monishram2508/strain-measurement-project/simulation/Strain_measurement.asc

C1: Cap; 1m
C2: Cap; 660n
R1: res; 120
R2: res; 120
R3: res; 120
R4: res; {120*(1+strain)}
R5: Res; 10k
R6: Res; 10k
R7: Res; 40
R8: Res; 10k
R9: Res; 10k
R10: Res; 10k
R11: Res; 10k
R12: Res; 47k
R13: Res; 47k
R14: Res; 87.5k
R15: Res; 12.5k
R16: Res; 47k
R17: Res; 24k
R18: Res; 10k
R19: Res; 10k
R20: Res; 10k
U1: UniversalOpAmp2
U2: UniversalOpAmp2
U3: UniversalOpAmp2
U4: UniversalOpAmp2
U5: UniversalOpAmp2
U6: UniversalOpAmp2
U7: UniversalOpAmp2
V1: voltage; 5
V2: voltage; 15
V3: voltage; -15
Named nets: 0, V+, V-, VA, VB, 5V
.include "ad620.cir"
.param strain=0
.step param strain -0.001 0.001 0.0001
.op
.dc param strain 0 0.001 0.00001
