monishram2508/strain-measurement-project/docs/strain-measurement-report.pdf

# IoT-Enabled Cantilever Beam Load Measurement System Using Strain Gauges

## Electronics Workshop II - Project Report

### Monishram Selvaraj Roll No: 2024102076

monishram.selvaraj@students.iiit.ac.in

### Neel Rajesh Roll No: 2024102007

neel.rajesh@students.iiit.ac.in

### International Institute of Information Technology Hyderabad

## 1 Introduction

Load and weight measurement is a fundamental requirement across a wide range of engineering applications, including structural health monitoring, industrial automation, weighing systems, and biomechanical research. Resistive strain gauges remain one of the most widely used transducers for such measurements due to their high sensitivity, small form factor, and well-understood electromechanical behaviour.
The fundamental operating principle of a resistive strain gauge is based on the piezoresistive effect: when a conductive element is mechanically deformed, its electrical resistance changes in proportion to the applied strain. For a metallic foil gauge, this relationship is characterised by the Gauge Factor (GF), defined as:

GF =

∆R/R
ε

(1)

where ∆R is the change in resistance, R is the nominal resistance, and ε is the mechanical strain. For standard metallic foil gauges, GF ≈ 2.
Despite widespread use, practical strain gauge systems present significant engineering challenges. The output signal of a Wheatstone bridge driven by a 5 V excitation and loaded with a typical foil gauge is in the millivolt range, necessitating high-gain, low-noise amplification before digitisation. Furthermore, thermal effects, common-mode interference, and bridge imbalance from manufacturing tolerances must be carefully managed.
This work addresses these challenges through a complete bottom-up system design, encompassing: (1) a half-bridge Wheatstone configuration for temperature-compensated differential sensing; (2) a custom discrete instrumentation amplifier for high-gain differential amplification; (3) an active signal conditioning stage for offset correction and low-pass filtering; and (4) an IoT subsystem for wireless data acquisition and live dashboard visualisation. The remainder of this paper is structured as follows. Section 3 covers the Wheatstone bridge design and analysis. Section 4 describes the instrumentation amplifier. Section 5 presents the signal conditioning stage. Section 6 details the IoT implementation. Section 8 presents experimental results, and Section ?? concludes the paper.

## 2 System Overview

The complete system signal chain is illustrated in Fig. 1. The strain gauges are bonded to the top and bottom surfaces of an aluminium cantilever beam. When a load is applied at the free end, one gauge experiences tensile strain and the other compressive strain, producing a differential resistance change. This differential signal is extracted by the Wheatstone bridge, amplified by the instrumentation amplifier, conditioned by the summing and filtering stage, digitised by the HX711, and transmitted wirelessly by the ESP32 to a local MQTT broker and Node-RED dashboard.

Wheatstone
Bridge

Instrumentation
Amplifier

Summer +
LPF

HX711

ADC | ESP32 | IoT Dashboard

Figure 1: System block diagram showing the complete signal chain from mechanical strain to IoT dashboard.

## 3 Wheatstone Bridge

### 3.1 Configuration and Motivation

The Wheatstone bridge is the fundamental transduction interface that converts the resistance change of the strain gauge into a measurable differential voltage. A half-bridge configuration was selected, comprising two active strain gauges (SG1, SG2) and two fixed resistors (R1, R2), as shown in Fig. 2.

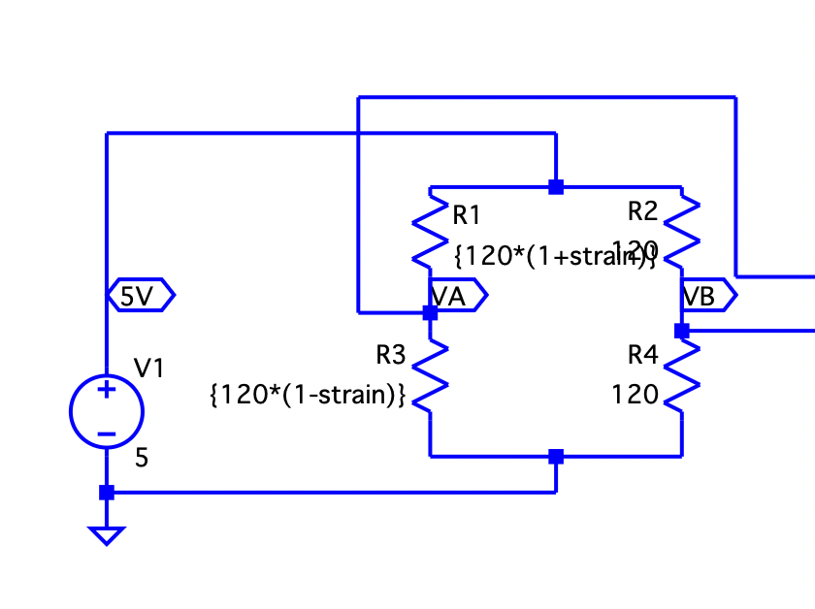
[picture p1: figure]

Figure 2: Half-bridge Wheatstone bridge schematic from LTspice. SG1 is bonded to the tensile face and SG2 to the compressive face of the cantilever beam. Fixed resistors R1 = R2 = 100 Ω.

The half-bridge configuration was preferred over a quarter-bridge for two key reasons:

1. Doubled sensitivity: With one gauge in tension and the other in compression, both contribute additively to the differential output, doubling the effective bridge output compared to a quarter-bridge arrangement.
2. Passive temperature compensation: Since both gauges are bonded to the same beam and experience the same ambient temperature, thermally induced resistance changes are common-mode and cancel differentially, significantly reducing thermal drift in the output signal.

### 3.2 Bridge Analysis and Output Voltage

The nominal resistance of the strain gauges was measured at 121.8 Ω. Under applied load, the gauges exhibit a resistance change of approximately ±0.5 Ω, corresponding to a strain of:

ε =

∆R/R
GF =

0.5/121.8
2
≈ 2050 µε | (2)

The differential output voltage of the half-bridge, with excitation voltage Vex = 5 V (from the ESP32 VIN pin), is given by:

Vdif f =

∆R
4R
- Vex | (3)

For ∆R = 0.5 Ω, R = 120 Ω, Vex = 5 V:

Vdif f =

0.5
4 × 120
× 5 ≈ 5.2 mV | (4)

This millivolt-level output confirms the necessity of high-gain amplification in the subsequent stage.

### 3.3 LTspice Simulation

The bridge was simulated in LTspice using a parametric resistance sweep to emulate strain variation:

. param strain =0
. step param strain -0.001 0.001 0.00005
R4 = {120*(1+ strain ) }

The simulation confirmed a linear differential output ranging from −2.5 mV to +2.5 mV across the swept strain range, consistent with theoretical predictions.

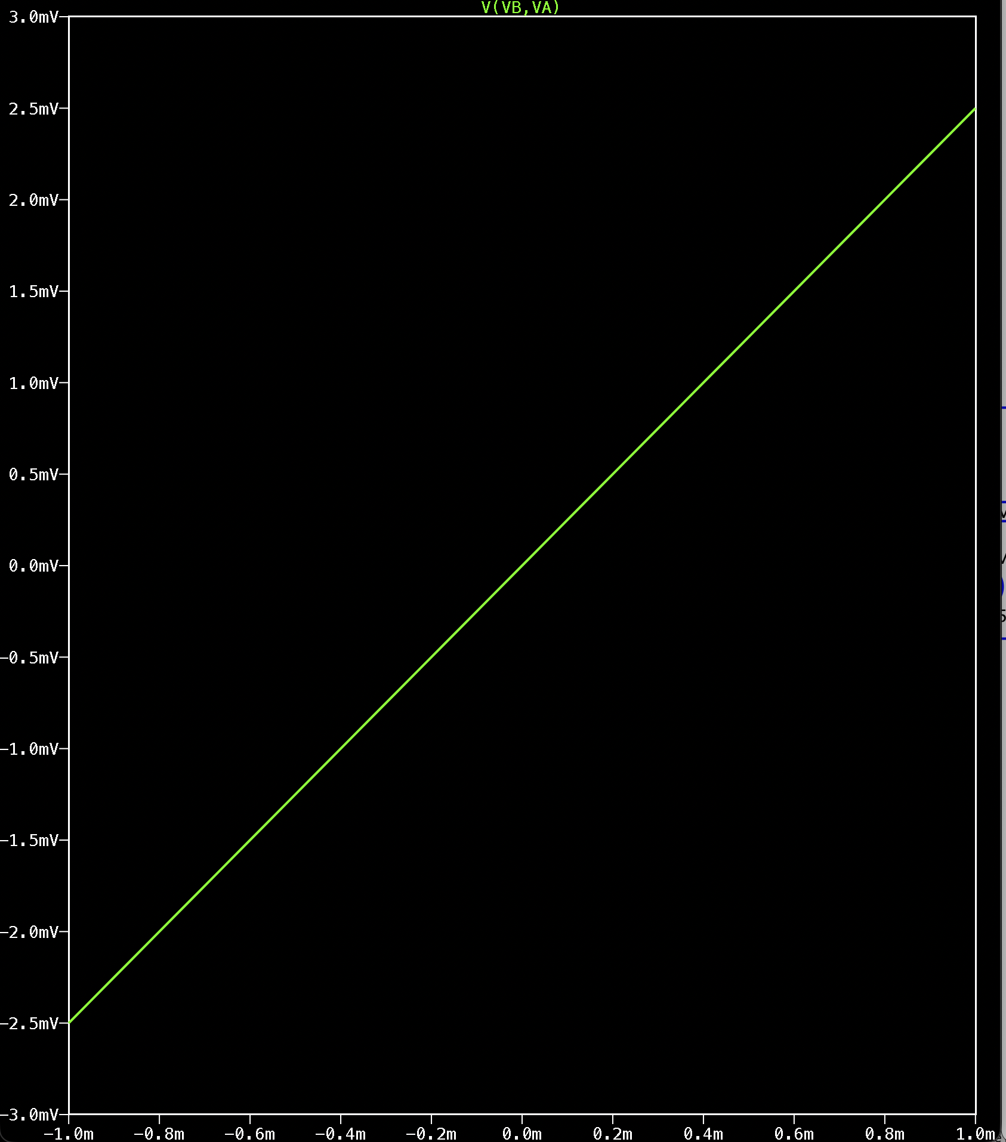
[picture p2: figure]

Figure 3: LTspice DC sweep result showing the differential bridge output V (A) − V (B) as a function of the strain parameter. The linear response from −2.5 mV to +2.5 mV confirms correct bridge operation.

### 3.4 Bridge Balancing Challenges

In practice, the fixed resistors measured 98 Ω and 99 Ω respectively (rather than an ideal 100 Ω), and the two strain gauges had slightly different nominal resistances. This resulted in a non-zero differential output at rest, observed as approximately −12 mV steady-state offset. This was addressed in software using the HX711 tare function, which captures and subtracts the resting output from all subsequent readings. To stick the strain gauge resistors onto the metal sheet was a tedious process. We had to sandpaper the metal sheet and make it as smooth as possible to ensure there were no bubbles after sticking it.

## 4 Custom Instrumentation Amplifier

### 4.1 Motivation and Design Choice

An instrumentation amplifier (INA) is required to amplify the small differential bridge output while rejecting common-mode interference. A discrete three-op-amp INA topology was implemented in hardware due to its high common-mode rejection ratio (CMRR), differential gain control via a single resistor, and high input impedance which minimises bridge loading. The AD620 was used as the reference model during LTspice simulation, with the hardware implementation realised using discrete op-amps in the classical three-op-amp INA configuration.

### 4.2 Circuit Topology

The three-op-amp INA consists of two input buffer amplifiers (U1, U2) followed by a differential output stage (U3), as shown in Fig. 10.

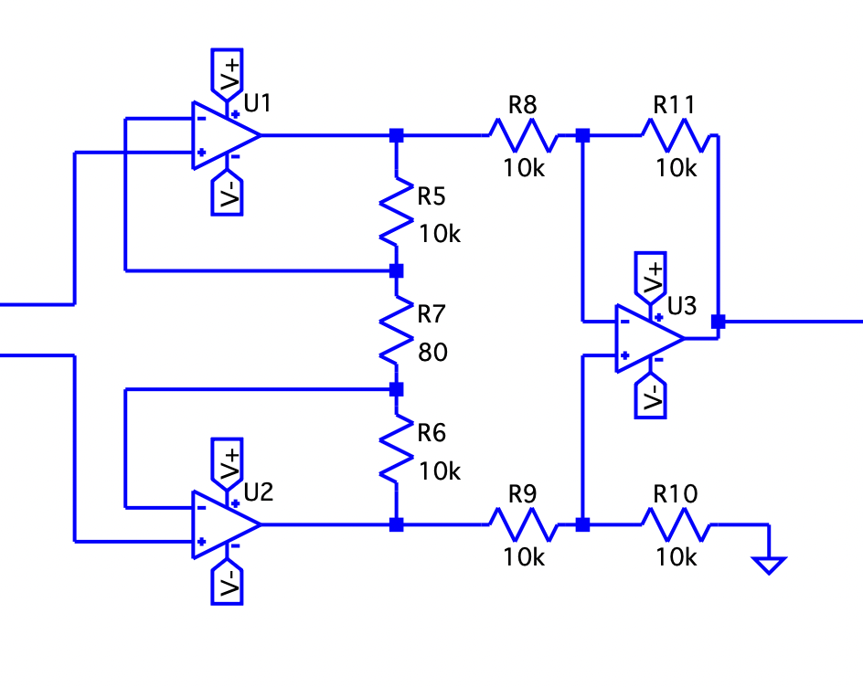
[picture p3: figure]

Figure 4: Custom three-op-amp instrumentation amplifier implemented in LTspice. U1 and U2 act as input buffers, while U3 forms the differential output stage. Gain is controlled by RG.

### 4.3 Gain Calculation

The gain of the three-op-amp INA is given by:

G = 1 +

2Rf
RG

(5)

where Rf is the feedback resistor and RG is the gain-setting resistor. In the hardware implementation, RG was realised as a 40 Ω fixed resistor in series with a 5 kΩ potentiometer, enabling continuously variable gain.
The required gain was derived from the desired output voltage range. To swing the output over a useful range of ≈ 3 V from a 4.7 mV bridge signal:

Grequired =

Vout

Vdif f

=

3
0.0047
≈ 638 | (6)

In practice, the gain was tuned empirically via the potentiometer (it increases or decreases the value of RG) to avoid saturation while maximising dynamic range.

### 4.4 Common-Mode Rejection

The INA topology inherently rejects common-mode signals. With matched resistors, the CMRR is theoretically infinite; in practice, resistor mismatch limits CMRR to typically 80 dB for discrete implementations. This is sufficient to reject 50 Hz mains interference and switching noise from the ESP32’s WiFi radio, both of which appear as common-mode signals on the bridge output lines.

### 4.5 Simulation Results

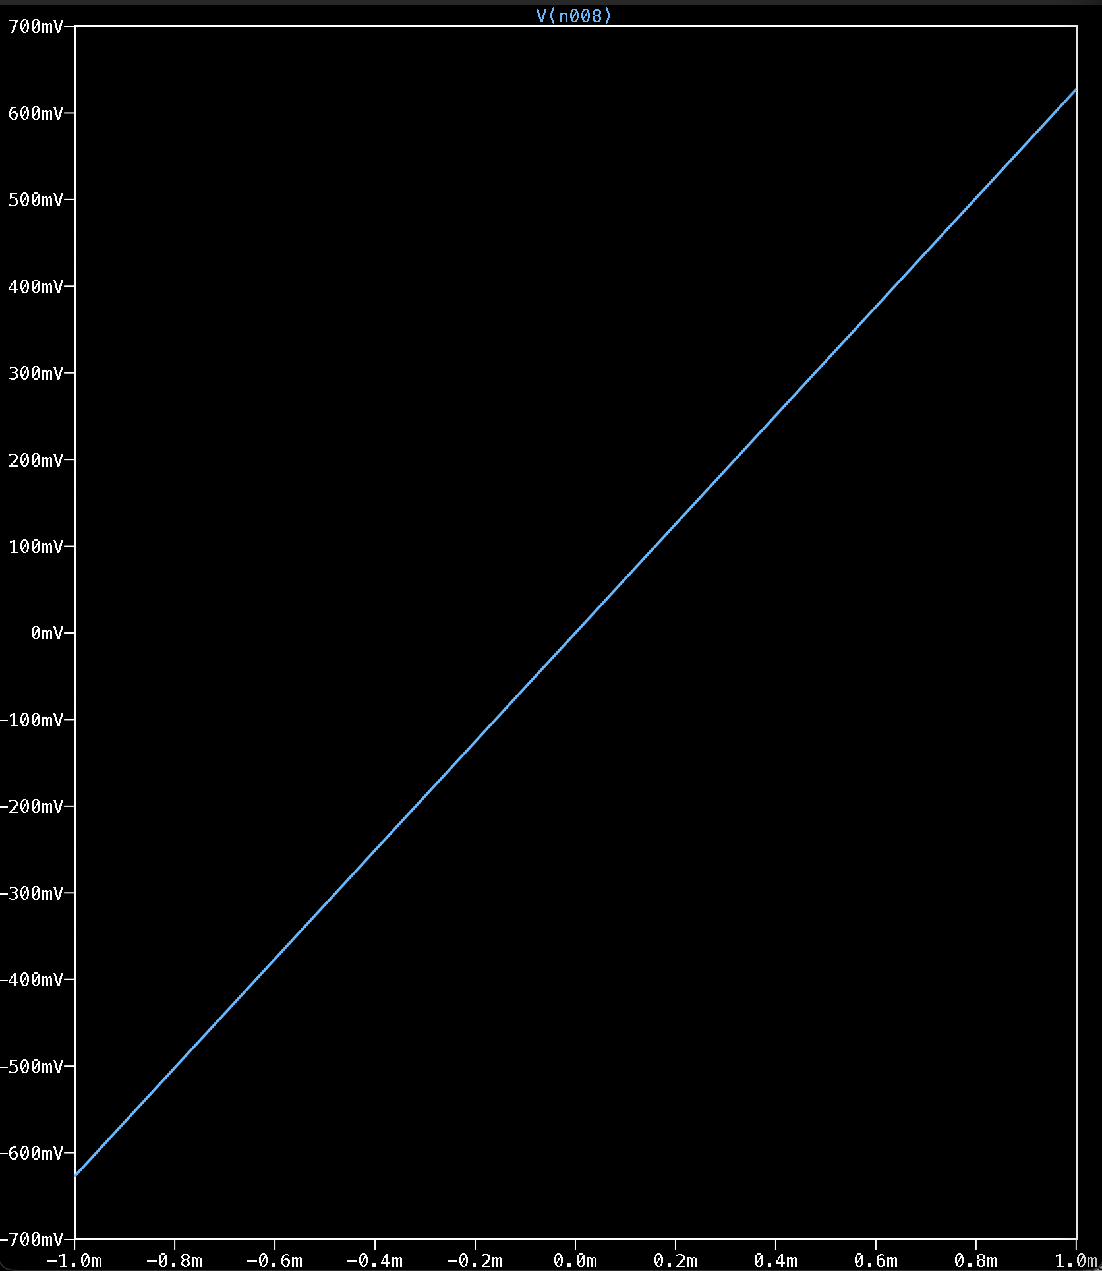
[picture p4: figure]

Figure 5: LTspice simulation of the instrumentation amplifier output versus strain sweep. The amplified output exhibits a linear response consistent with the designed gain and is centered around 0V.

## 5 Signal Conditioning: Inverting Summer and Low-Pass Filter

### 5.1 Overview

Following amplification, the signal requires two further processing steps before digitisation:

1. DC offset correction: The INA output carries a DC offset due to bridge imbalance and the REF pin voltage. An inverting summing amplifier is used to subtract this offset, centering the signal around zero.
2. Low-pass filtering: High-frequency noise from power supply ripple, mechanical vibration, and electromagnetic interference must be attenuated. An active low-pass filter with gain achieves this.

### 5.2 Inverting Summing Amplifier

The inverting summing amplifier combines the INA output with a precision DC reference voltage (Vref = 0.6 V), generated by a unity-gain voltage buffer (U6) driven by a resistor divider from the 5 V supply:

Vref = Vsupply ×

R15

R14 + R15

= 5 ×

12.5 k
87.5 k + 12.5 k = 0.625 V | (7)

The summing amplifier output is:

Vsum = −

Rf

Rin1

VINA +

Rf

Rin2

Vref
(8)

With Rin1 = Rin2 = Rf = 47 kΩ, this gives unity summing gain with sign inversion, effectively subtracting the reference from the INA output.

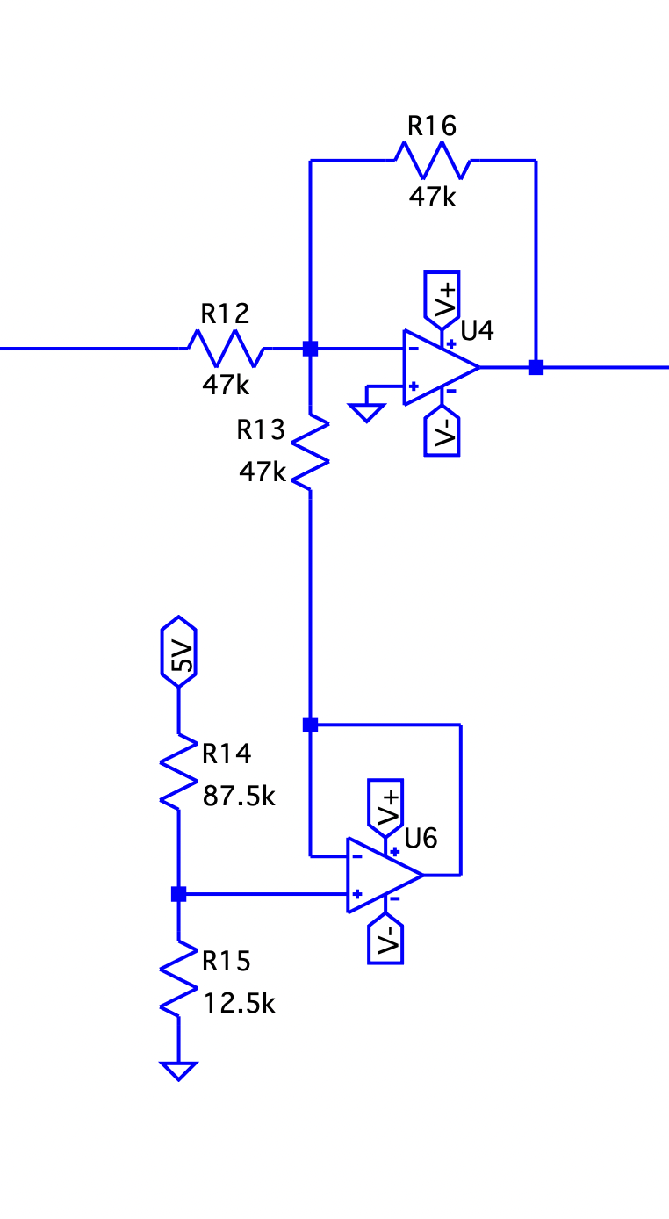
[picture p5: figure]

Figure 6: LTspice schematic of the inverting summing amplifier and voltage reference buffer. R12, R13, R16 = 47 kΩ; R14 = 87.5 kΩ; R15 = 12.5 kΩ.

### 5.3 Active Low-Pass Filter with Gain

An active Sallen-Key low-pass filter with additional gain was implemented following the summing stage. The cutoff frequency is given by:

fc =

1
2πRC | (9)

For R = 10 kΩ and C = 1 µF:

fc =

1
2π × 10 k × 1 µ
≈ 15.9 Hz | (10)

This cutoff frequency is appropriate for quasi-static load measurement: structural loads change slowly (well below 10 Hz), while the dominant noise sources (50 Hz mains, WiFi switching at MHz frequencies) are well above the passband. The filter attenuates these at −20 dB/decade.
An additional gain stage (R17 = 24 kΩ, R18 = 10 kΩ, C2 = 660 nF) follows the filter to scale the output to a 0–3 V range suitable for the subsequent ADC stage.

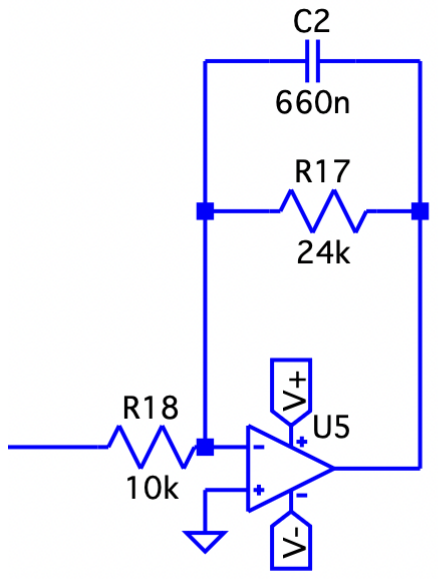
[picture p6: figure]

Figure 7: LTspice schematic of the active low-pass filter with gain stage. R17 = 24 kΩ, R18 = 10 kΩ, C2 = 660 nF.

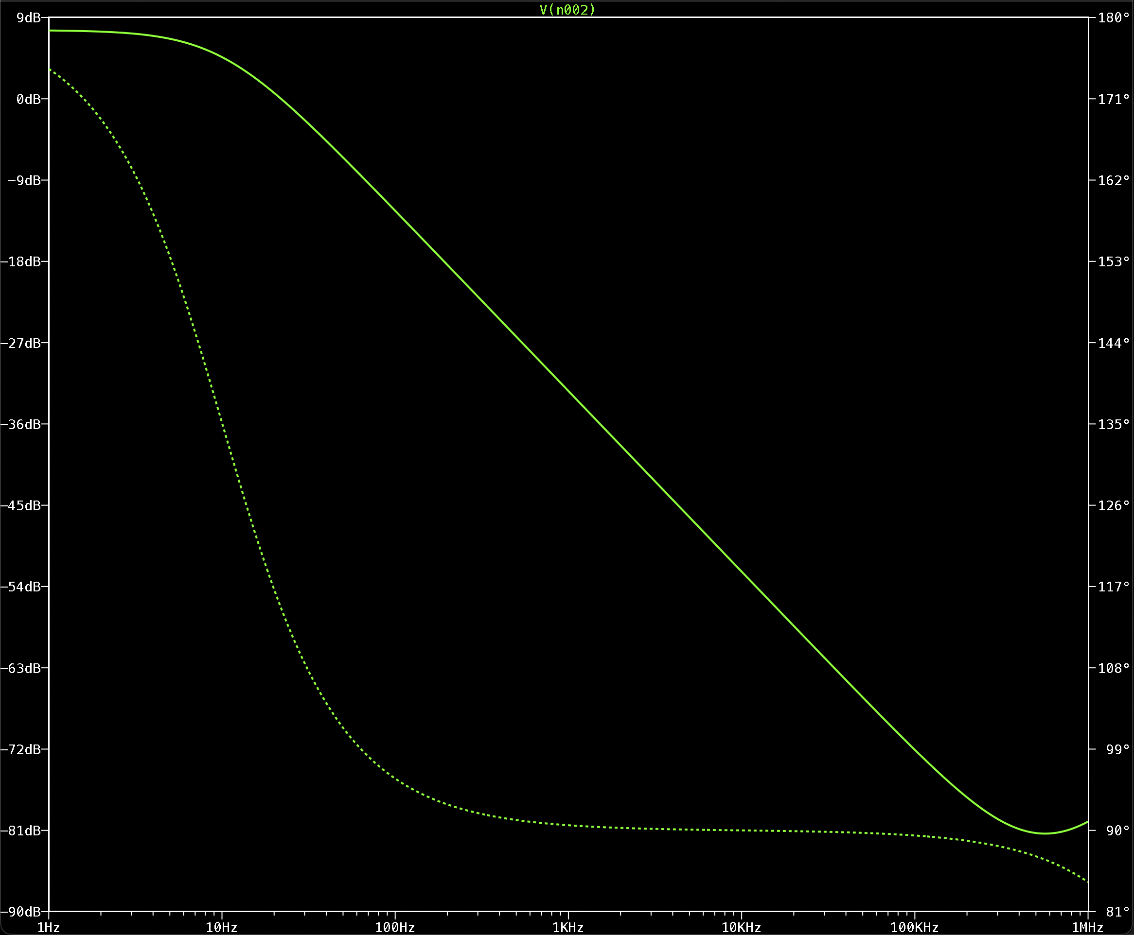
[picture p7: figure]

Figure 8: AC analysis of the low-pass filter stage, showing the −3 dB cutoff at approximately 15.9 Hz and −20 dB/decade roll-off beyond the passband.

### 5.4 Output Range Verification

The complete analog signal chain produces an output in the range of 0 V to 3 V, verified in both simulation and hardware. At zero strain, the output is centred near 1.5 V; at maximum compressive strain the output approaches 0 V, and at maximum tensile strain it approaches 3 V.

## 6 IoT Implementation

### 6.1 System Architecture

The IoT subsystem was designed to transmit weight measurements wirelessly to a live browser dashboard with minimal latency. The architecture is entirely local — no cloud services are used — ensuring low latency, privacy, and operation without internet connectivity. The stack comprises:

- HX711: 24-bit sigma-delta ADC with integrated programmable gain amplifier, designed specifically for Wheatstone bridge interfacing.
- ESP32: Dual-core 240 MHz microcontroller with integrated WiFi, running the Arduino framework.
- Mosquitto: Open-source MQTT broker running locally on a laptop.
- Node-RED: Flow-based visual programming environment hosting the dashboard at http://localhost:1880/ui.

### 6.2 HX711 ADC Interface

The HX711 was selected over the ESP32’s internal 12-bit SAR ADC for two reasons: its 24-bit resolution provides significantly finer quantisation (16 million counts versus 4096), and its dedicated differential input is optimised for Wheatstone bridge signals, with an internal PGA supporting gains of 32, 64, and 128.
In this implementation, the bridge output was connected directly to the HX711 Channel A inputs (A+, A-) at a gain of 128, bypassing the external instrumentation amplifier for the final hardware configuration. The HX711 effective input range at gain 128 and Vsupply = 4.5 V is:

Vin,max = ±

Vsupply
2 × Gain = ±

4.5
2 × 128
≈ ±17.6 mV | (11)

The HX711 communicates with the ESP32 via a custom two-wire serial protocol using a clock pin (SCK, GPIO5) and data pin (DT, GPIO4).

### 6.3 MQTT Communication

Weight data is published to the MQTT topic strain/weight at 2 Hz. The ESP32 acts as an MQTT client connecting to the Mosquitto broker at the laptop’s local IP address over the shared WiFi hotspot. Node-RED subscribes to this topic and updates the dashboard gauge widget in real time.
The MQTT protocol was selected for its low overhead, publish-subscribe architecture, and native support in both the ESP32 Arduino ecosystem (PubSubClient library) and Node-RED.

### 6.4 Calibration Procedure

Empirical calibration was performed by placing objects of known weight on the beam and recording the corresponding raw HX711 counts after taring. The scale factor k (counts per gram) is defined as:

k =

Craw
m

(12)

where Craw is the tared raw count and m is the known mass in grams. The calibration data is presented in Table 1.

Table 1: Empirical Calibration Data

Object | Mass (g) Raw Count Scale Factor (counts/g)
iPhone 16 Pro | 210 | 7000 | 33.3
JBL Go 2 | 184 | 6750 | 36.7
AirPods Pro 3 | 55 | 5509 | 100.2
Water Bottle (300 ml) | 310 | 7961 | 25.7
Average | – | – | 49.0

The variance in scale factor across the calibration objects reflects several practical factors: the nonlinearity of the beam’s mechanical response at different load levels, the sensitivity of the half-bridge to load placement position on the beam, and the thermal drift of the gauge resistance between measurements. A more robust calibration would involve a polynomial fit across a wider and denser set of reference masses, which is identified as future work.

### 6.5 Firmware

The ESP32 firmware was developed in the Arduino framework. The core measurement loop reads averaged HX711 counts, applies the scale factor, publishes the result to MQTT, and prints to the serial monitor simultaneously. A software tare routine captures the resting baseline count on demand and subtracts it from all subsequent readings, compensating for bridge imbalance and thermal offset.

Listing 1: Core ESP32 firmware loop

void loop () {
if (! client . connected () ) reconnect () ; client . loop () ;

if ( scale . is_ready () ) {
long raw = scale . read_average (20) ;
long adjusted = raw - zero_offset ;
float weight = adjusted / calibration_factor ; char msg [50];
dtostrf ( weight , 6 , 2 , msg ) ;

client . publish (" strain / weight ", msg ) ; Serial . print (" Weight :␣") ;
Serial . print ( weight ) ;
Serial . println ("␣g") ;
}
delay (500) ;
}

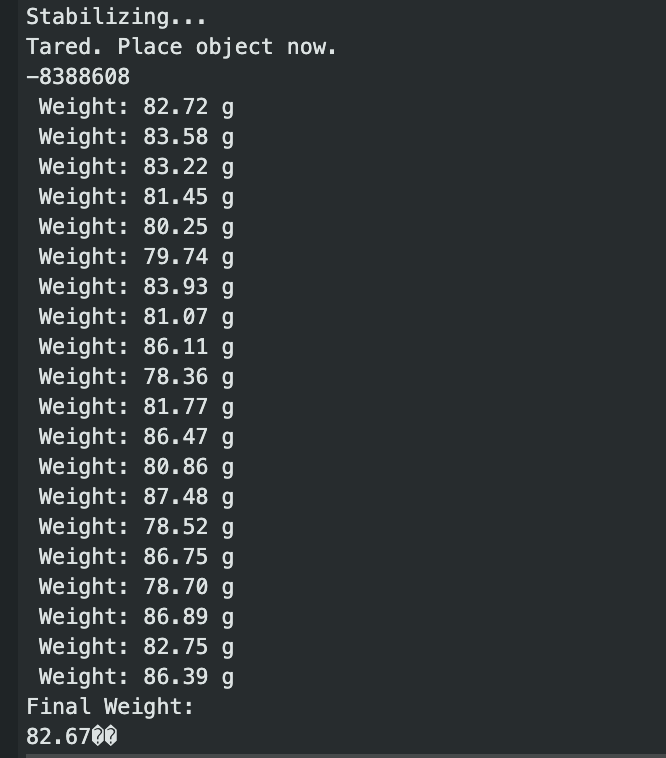
[picture p8: figure]

Figure 9: Real-time weight of the adapter measured by the strain gauge on serial monitor

## 7 Challenges and Solutions

The development process surfaced several non-trivial engineering challenges, each of which required systematic diagnosis and resolution.

### 7.1 Thermal Drift

Observation: On power-up, HX711 raw counts drifted from approximately +50,000 to near zero over a 15–20 minute period, even without any applied load.
Root Cause: Self-heating of the strain gauges due to excitation current. The excitation current through a 120 Ω gauge at 4.5 V generates ohmic heating, raising the gauge temperature and consequently its resistance. This is a well-known phenomenon in strain gauge metrology called self-heating error.
Solution: A mandatory warm-up period of 15–20 minutes was incorporated into the measurement procedure. The software tare is triggered only after readings stabilise, rather than automatically on startup.

### 7.2 Ground Loop Noise

Observation: Random, high-amplitude fluctuations (±1000 counts) in HX711 readings that did not correlate with beam deflection.
Root Cause: Two separate ground wires were routed from the ESP32 to the HX711 (one to the GND pin, one to E-). This created a ground loop: small current differences between the two return paths generated a fluctuating common-mode voltage that was picked up as a differential signal.
Solution: Both HX711 GND and E- were connected to a single ground node, with only one wire returning to the ESP32 GND pin, eliminating the loop.

### 7.3 Bridge Imbalance

Observation: A steady-state differential output of approximately −12 mV was observed even at zero applied load.
Root Cause: The two fixed bridge resistors measured 98 Ω and 99 Ω (rather than ideal matching), and the two strain gauges had different nominal resistances, resulting in an inherently unbalanced bridge.
Solution: The offset was compensated in software using the HX711 tare function, which captures and subtracts the resting raw count from all subsequent measurements.

### 7.4 LTspice Symbol Pin Mapping Error

Observation: The simulated AD620 instrumentation amplifier produced a gain of less than unity (attenuation) rather than the designed gain of ≈ 144.
Root Cause: When a custom symbol was drawn for the AD620 in LTspice, the SpiceOrder attribute of each pin in the .asy file did not correctly match the argument order of the .SUBCKT definition. Specifically, the RG pin was mapped to the IN+ subcircuit node, effectively shorting the input and collapsing the gain.
Solution: The .asy file was corrected by explicitly assigning SpiceOrder values to each pin to match the .SUBCKT AD620 1 2 99 50 46 20 7 8 argument order precisely.

### 7.5 HX711 Input Saturation Risk

Observation: The initial design routed the AD620 output (amplified to several volts) directly into the HX711 analog input.
Root Cause: Misunderstanding of the HX711 input architecture. The HX711 Channel A differential input range at gain 128 is only ±17.6 mV. Feeding an amplified signal of several volts would have saturated or damaged the input stage.

Solution: The external INA was bypassed for the hardware implementation, and the bridge was connected directly to the HX711 inputs, utilising the HX711’s internal PGA for amplification.

## 8 Experimental Results

### 8.1 Resistance Change Characterisation

The strain gauge resistance was measured using a precision multimeter while progressively loading the cantilever beam. The nominal resistance at rest was 121.8 Ω. At maximum applied deflection (limited by beam geometry), a resistance change of ±0.5 Ω was observed on each gauge, corresponding to a strain of ε ≈ 2050 µε as calculated in (2).

### 8.2 HX711 Raw Count Response

After taring, the HX711 raw counts increased monotonically with applied load, confirming the correct polarity and monotonicity of the measurement chain. Representative steady-state readings at rest and under load were stable within ±15 counts after the warm-up period, corresponding to a weight uncertainty of approximately ±0.4 g at the nominal scale factor.

### 8.3 Calibration Results

The calibration data in Table 1 reveals a spread in scale factor from 25.7 to 100.2 counts/-gram. This spread is attributed to:

- Load position sensitivity: The beam’s mechanical response is position-dependent. A load placed closer to the fixed end produces less deflection and hence fewer counts per gram than the same load at the free end.
- Thermal drift between measurements: The baseline count drifted between successive calibration measurements, introducing systematic error in the tared readings.
- Nonlinearity at low loads: At very low loads (e.g., AirPods Pro at 55 g), the signalto-noise ratio is lower, and the scale factor estimate is less reliable.

### 8.4 Dashboard Visualisation

The Node-RED dashboard displayed live weight readings on a gauge widget, updating at 2 Hz over MQTT. The dashboard was successfully accessed from a second device connected to the same WiFi hotspot, demonstrating the networked IoT capability of the system.

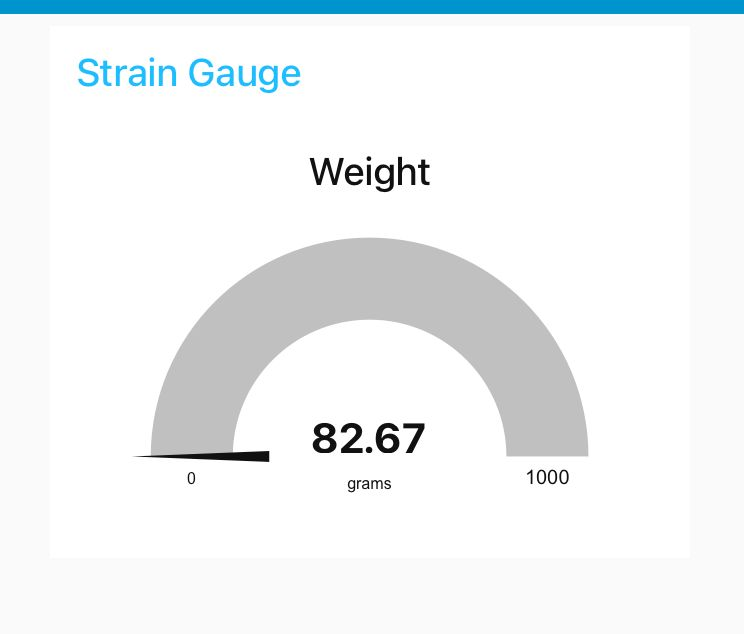
[picture p9: figure]

Figure 10: Weight of the Adapter

## 9 Discussion/Conclusion

These are the links for the videos that test the weight of the adapter and that shows the working of the wheatstone bridge converting the resistance change to voltage change. Watch Multimeter Readings. (https://iiithydstudents-my.sharepoint.com/:v:/g/personal/neel_rajesh_students_iiit_ac_in/IQBI6rbudOTgSaqQSm296TVdAVxFaHKnMmeO7H8h60TwXWo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)
Watch Serial Monitor Readings. (https://iiithydstudents-my.sharepoint.com/:v:/g/personal/neel_rajesh_students_iiit_ac_in/IQBywzB4ACA9TI_HkEsj_mVgAQAnMG6tuzO2a4TdsgrzqLE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)
The implemented system successfully demonstrates end-to-end strain-based weight measurement with IoT integration. However, several limitations of the current implementation merit discussion.
The most significant practical challenge was thermal drift, which required a lengthy warm-up period and precluded rapid successive measurements. In a production system, this would be addressed through the use of a dummy gauge (a gauge bonded transversely to the beam, unresponsive to longitudinal strain but equally affected by temperature) as the fourth arm of a full bridge, providing continuous passive temperature compensation.
The single-point empirical calibration (using a fixed scale factor) is adequate for demonstration but introduces systematic error across the load range. A polynomial regression over a larger set of calibration points would yield significantly better accuracy, particularly at the extremes of the measurement range.
The use of a breadboard for prototyping introduced intermittent contact failures, particularly at the high-impedance HX711 differential inputs. Migration to a soldered perfboard or PCB would substantially improve reliability and reduce susceptibility to mechanical and thermal disturbance.
