monishram2508/strain-measurement-project/(commit log)

2026-04-20 added ltspice circuit simulations
2026-08-02 clean up
    [calibration.csv]
